Eyegis-Garr/CS425-Automatic-Pressure-Control-Module/Images/MachineUI.jpg

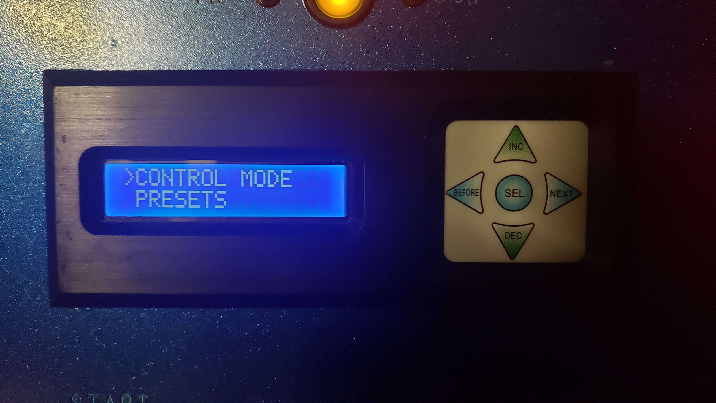
Images/MachineUI.jpg
