Eyegis-Garr/CS425-Automatic-Pressure-Control-Module/Images/ControlPanel.jpg

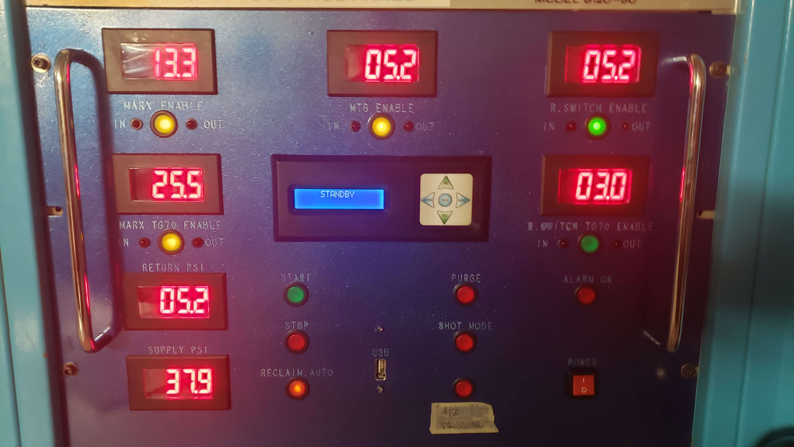
Images/ControlPanel.jpg
