Eyegis-Garr/CS425-Automatic-Pressure-Control-Module/Project Website Link.md

https://eyegis-garr.github.io/CS426ProjectWebsite.github.io/
