Eyegis-Garr/CS425-Automatic-Pressure-Control-Module/Images/SystemContextModel.png

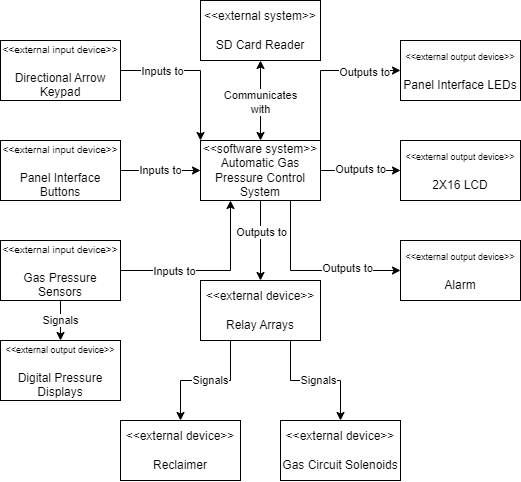
Images/SystemContextModel.png
