Eyegis-Garr/CS425-Automatic-Pressure-Control-Module/Bezel.stl

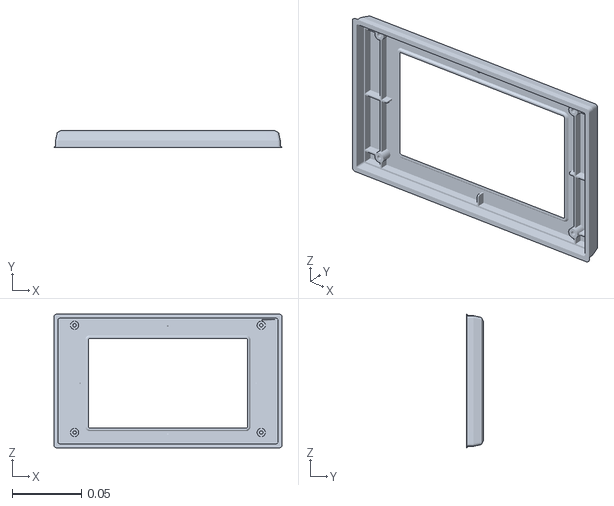
[picture p4: CAD file, 2024-02-22]
Bezel.stl
0.165 x 0.0122 x 0.0968
