Eyegis-Garr/CS425-Automatic-Pressure-Control-Module/(commit log)

2024-02-14 3D Model for touchscreen bezel
    [Bezel_2.stl]
2024-02-22 Added updated Bezel model for size corretions
    [Bezel.stl]
2024-02-22 Uploaded Bezel. Again.
    [Bezel.stl]
2024-03-01 Update and rename Pressure-Controller_2_15.ino to Pressure-Controller_New_Hardware.ino
2024-03-01 Update Pressure-Controller_New_Hardware.ino
    Adding framework for touchscreen hardware
2024-03-13 Framework for saving, loading, and delete preset
2024-03-15 Update Pressure-Controller_New_Hardware.ino
    re-implemented the load and delete function
2024-03-15 Update Pressure-Controller_New_Hardware.ino
    Added graphics
2024-03-21 Working on purge timers
2024-03-26 Finished purge timer function
2024-04-09 Finished pressure set functions
2024-04-10 Added calibration triggers 8 and 9
    Calibration is performed to compute the correct Analog-per-PSI conversion coefficients. Since each circuit reports pressures in linear increments of voltages (i.e. PSI and Analog readings scale linearly), a calibrating simply requires computing the slope for a single data-point. Trigger 8 is responsible for retrieving the user circuit-selection and current circuit-PSI, and then computes the calibration coefficient if the input PSI is nonzero. Trigger 8 will page from the Calibration page to a Calibrated status page displaying the changes made. Trigger 9 will update the GUI with the current circuit-string given the selection as a circuit-index, using a simpl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
    [Pressure-Controller_New_Hardware.ino]
